knuthelgesen/Sustainer/docs/img/potentiometer_tab.jpg

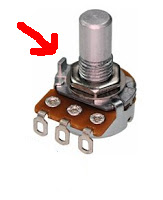
docs/img/potentiometer_tab.jpg
