knuthelgesen/Sustainer/docs/bilder/img_20200101_171444.jpg

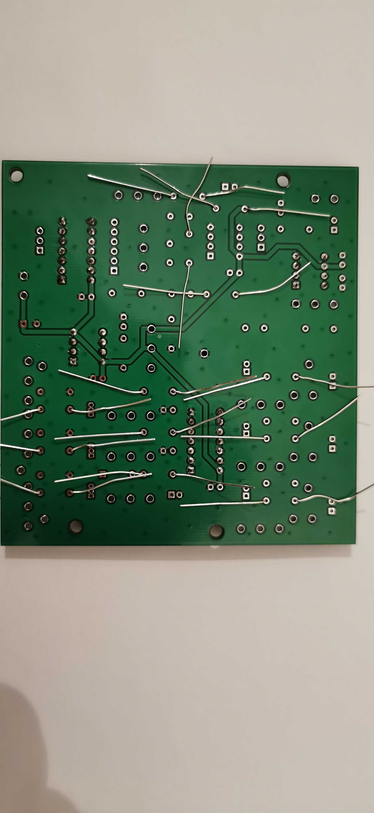
docs/bilder/img_20200101_171444.jpg
