knuthelgesen/Sustainer/docs/bilder/img_20200106_183125.jpg

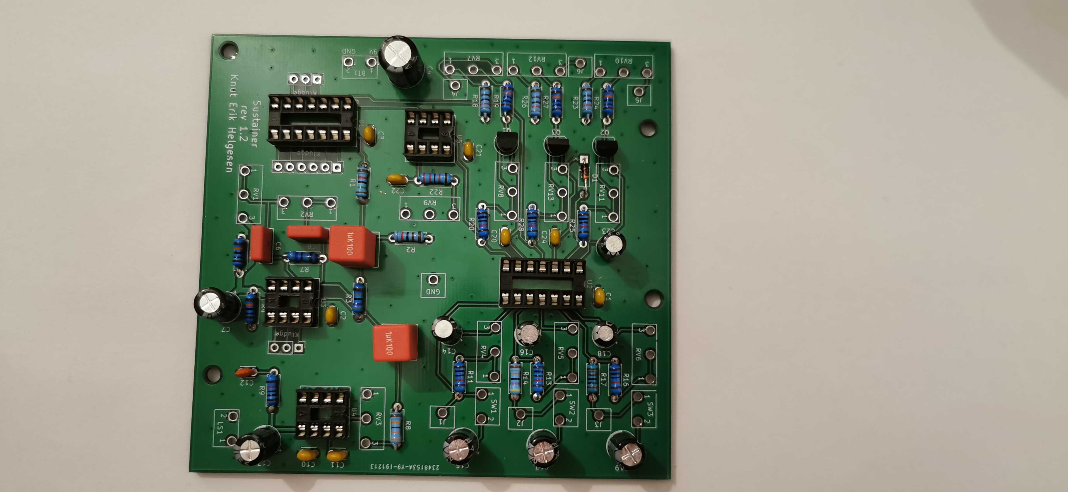
docs/bilder/img_20200106_183125.jpg
