knuthelgesen/Sustainer/docs/img/gated_oscillator.png

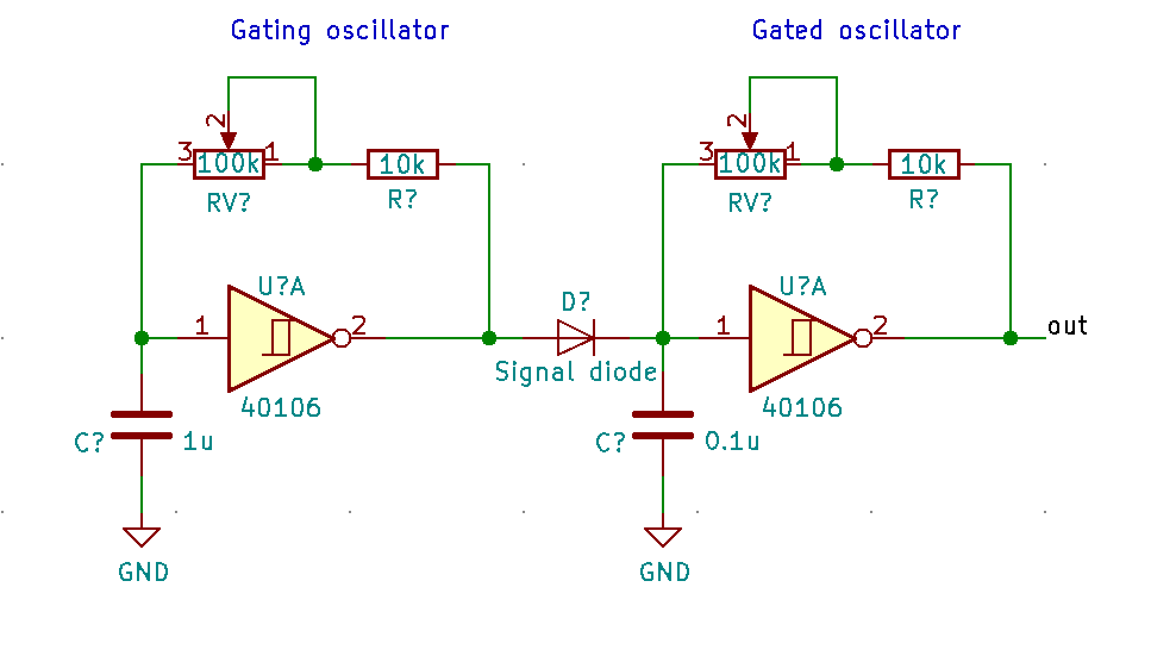
docs/img/gated_oscillator.png
