knuthelgesen/Sustainer/docs/img/potentiometer_pins.jpg

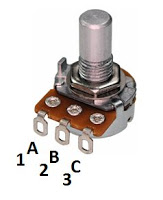
docs/img/potentiometer_pins.jpg
