knuthelgesen/Sustainer/docs/img/simple_oscillator.png

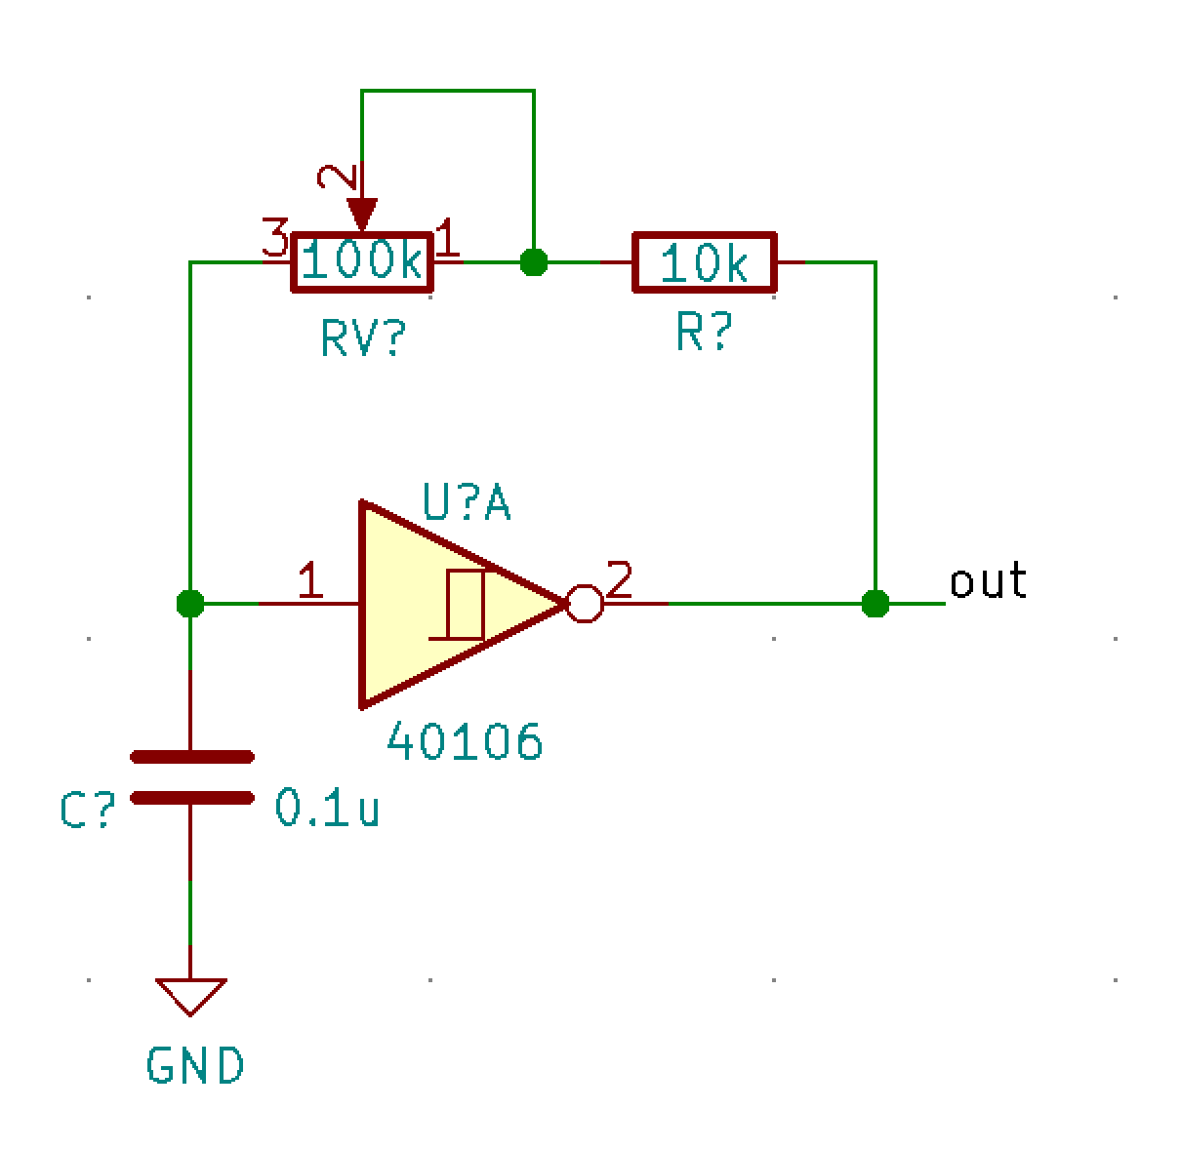
docs/img/simple_oscillator.png
