knuthelgesen/Sustainer/BOM.ods

Cateogry | Component | Count | Unit cost ($) | Total cost ($)
IC | CD40106 | 1 | $0.26 | $0.26
IC | LM358 | 1 | $0.16 | $0.16
IC | LM386 | 1 | $0.23 | $0.23
IC | CD4070 | 1 | $0.21 | $0.21
IC | NE555 | 1 | $0.13 | $0.13
Socket | 8 pin | 3 | 0.03
Socket | 14 pin | 2 | 0.05
Resistor | 1K
Potentiometer | 100K
Potentiometer | 1M
 |  |  |  | 0.99
