knuthelgesen/Sustainer/Sustainer.pdf

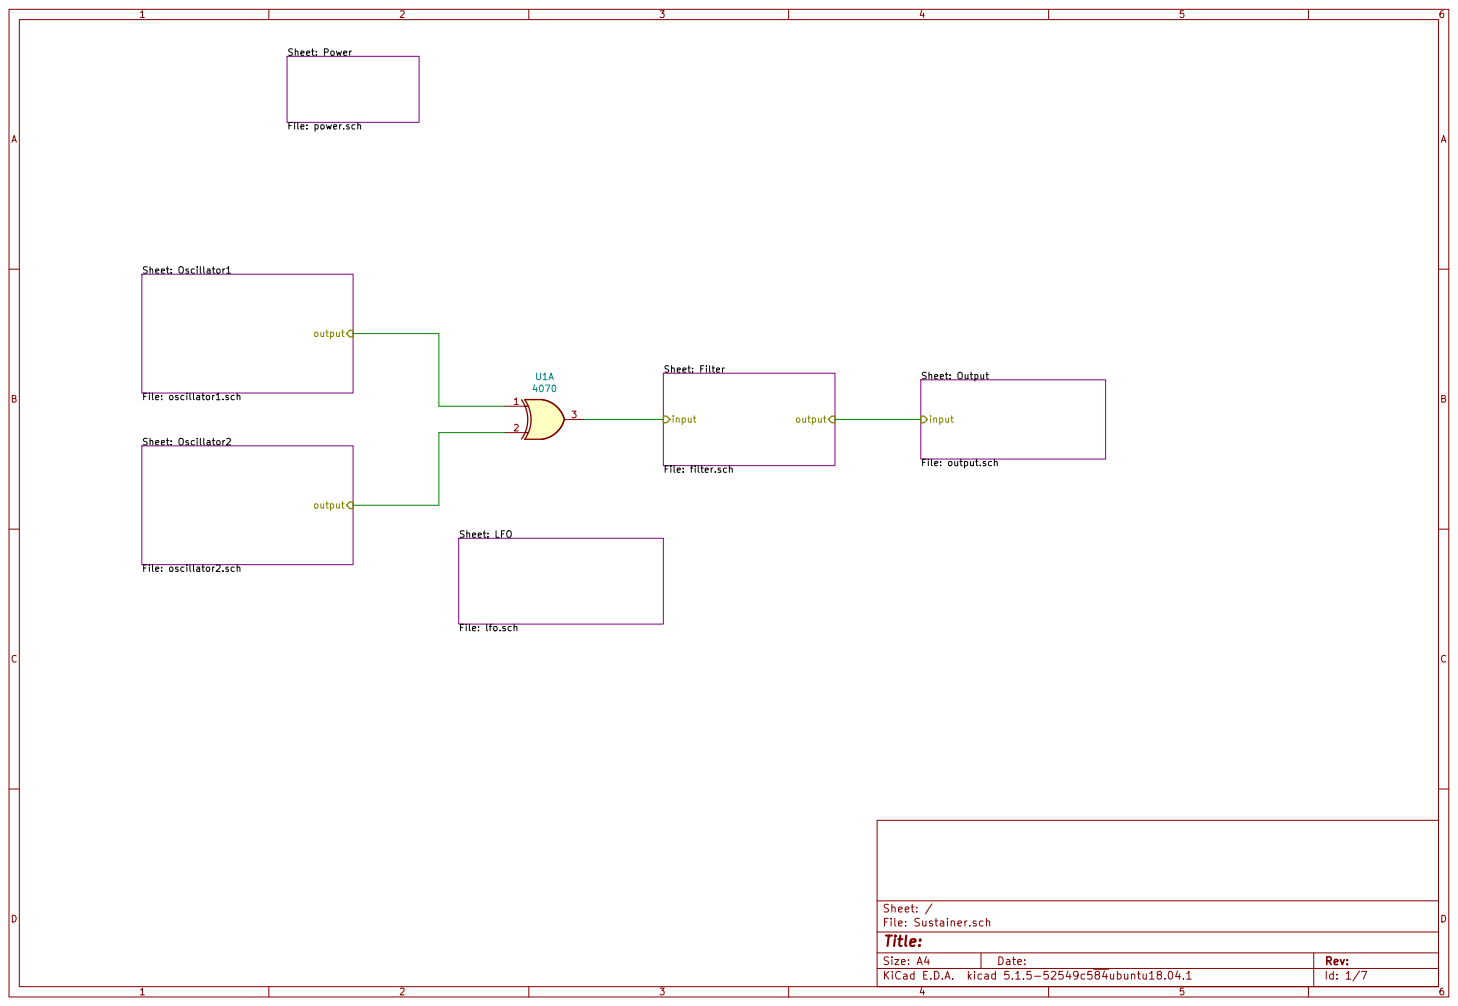
[picture p7: page 1]

File: lfo.sch Sheet: Oscillator1 File: oscillator1.sch

output Sheet: Oscillator2 File: oscillator2.sch

Id: 1/7 Title: File: Sustainer.sch Sheet: /

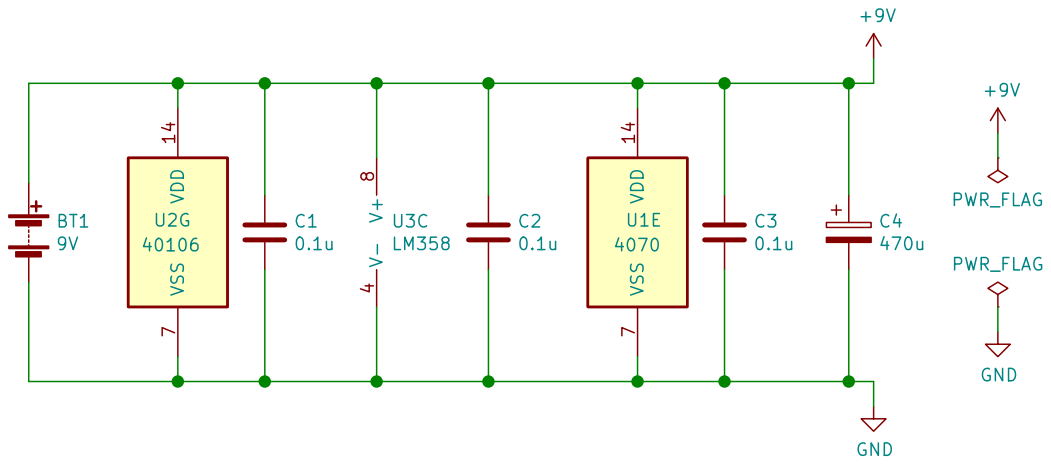
[picture p8: page 2]

File: power.sch Sheet: /Power/
Id: 2/7 Title:

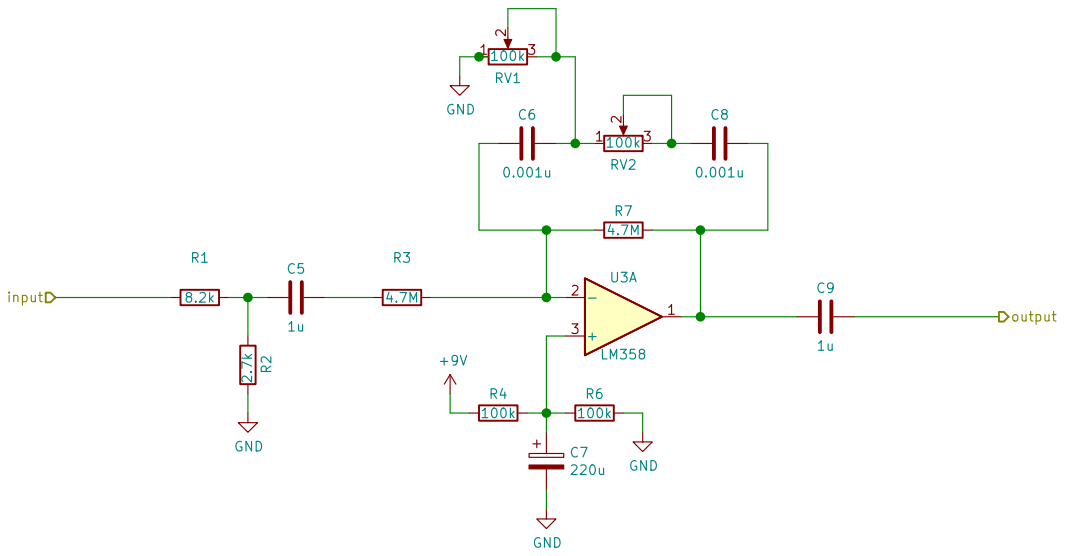
[picture p9: page 3]

Id: 3/7 Title: File: filter.sch Sheet: /Filter/ C5

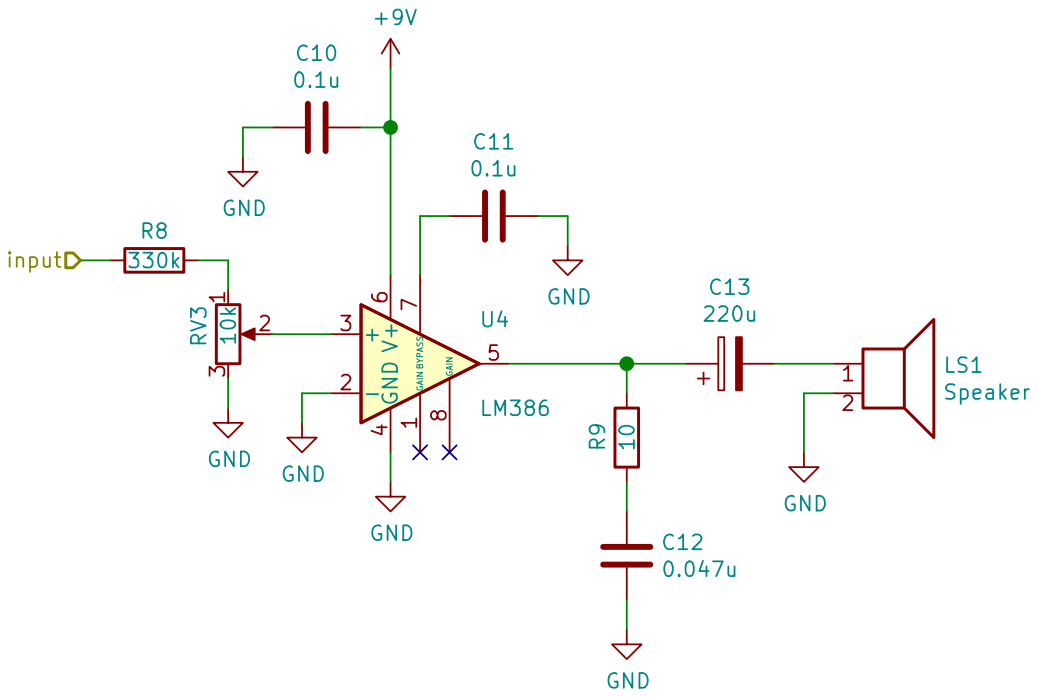
[picture p10: page 4]

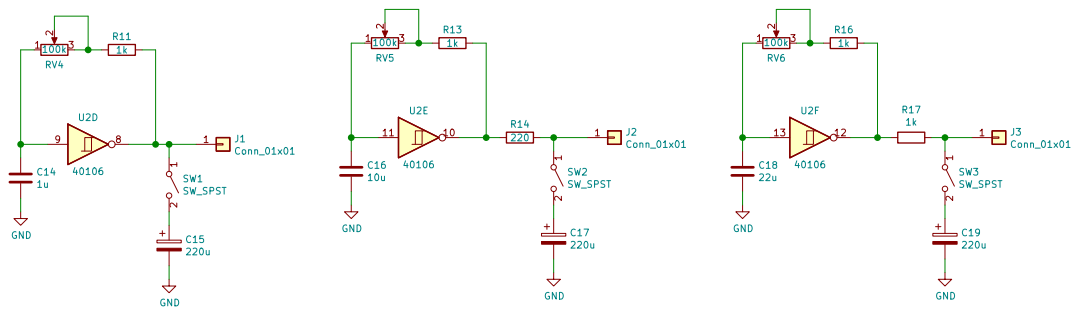
[picture p11: page 5]

40106 GND
Id: 5/7 Title: File: lfo.sch Sheet: /LFO/ C16

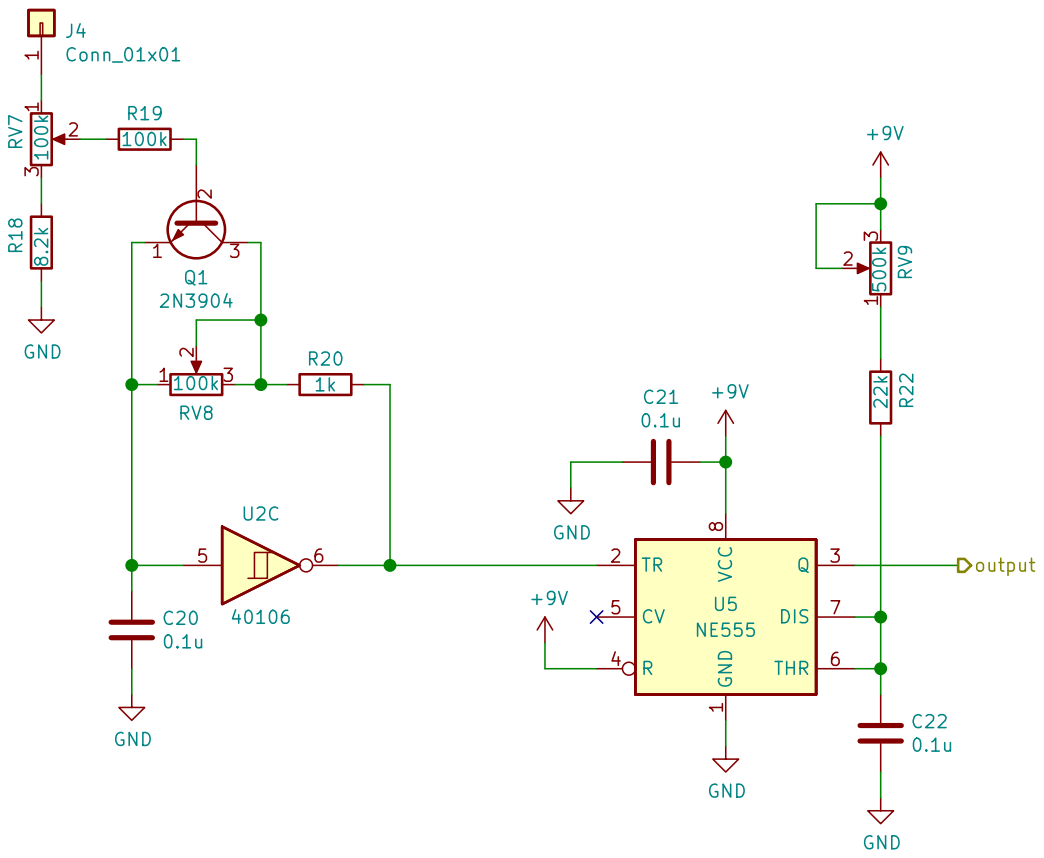
[picture p12: page 6]

Id: 6/7 Title: File: oscillator1.sch Sheet: /Oscillator1/

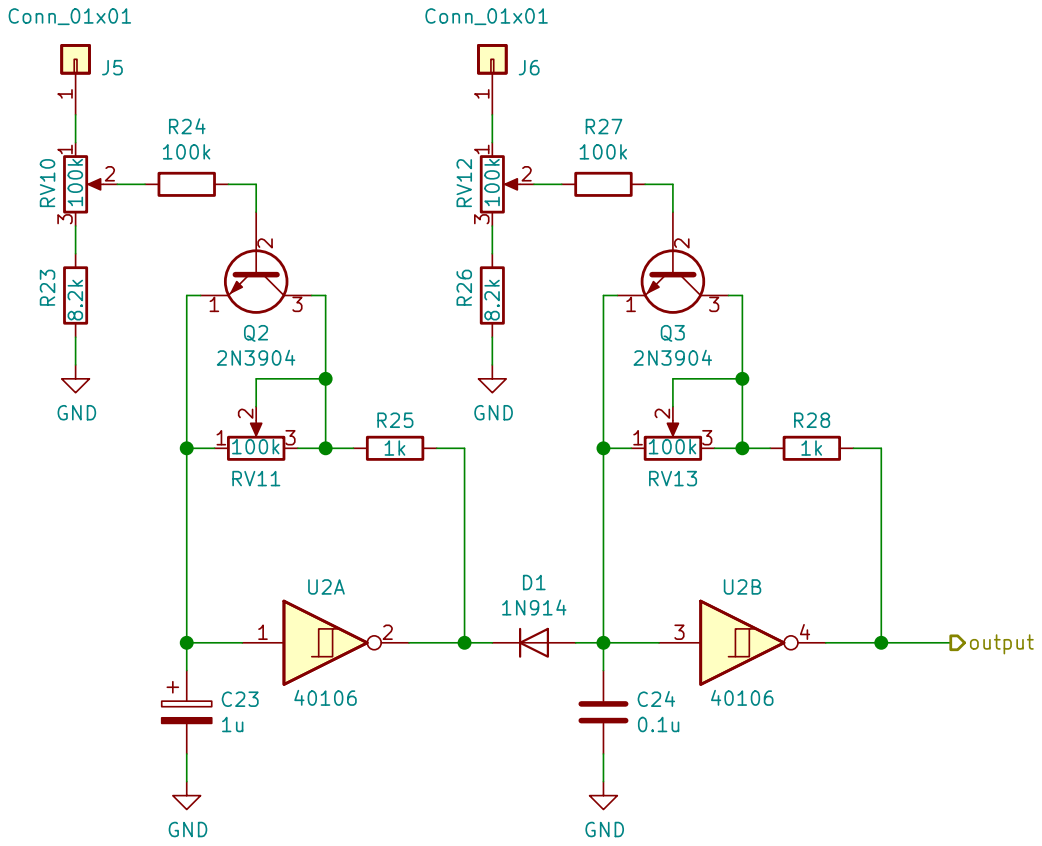
[picture p13: page 7]

Id: 7/7 Title: File: oscillator2.sch Sheet: /Oscillator2/
