knuthelgesen/Sustainer/Sustainer.kicad_pcb

## KiCad design Sustainer.kicad_pcb (2019-12-21)

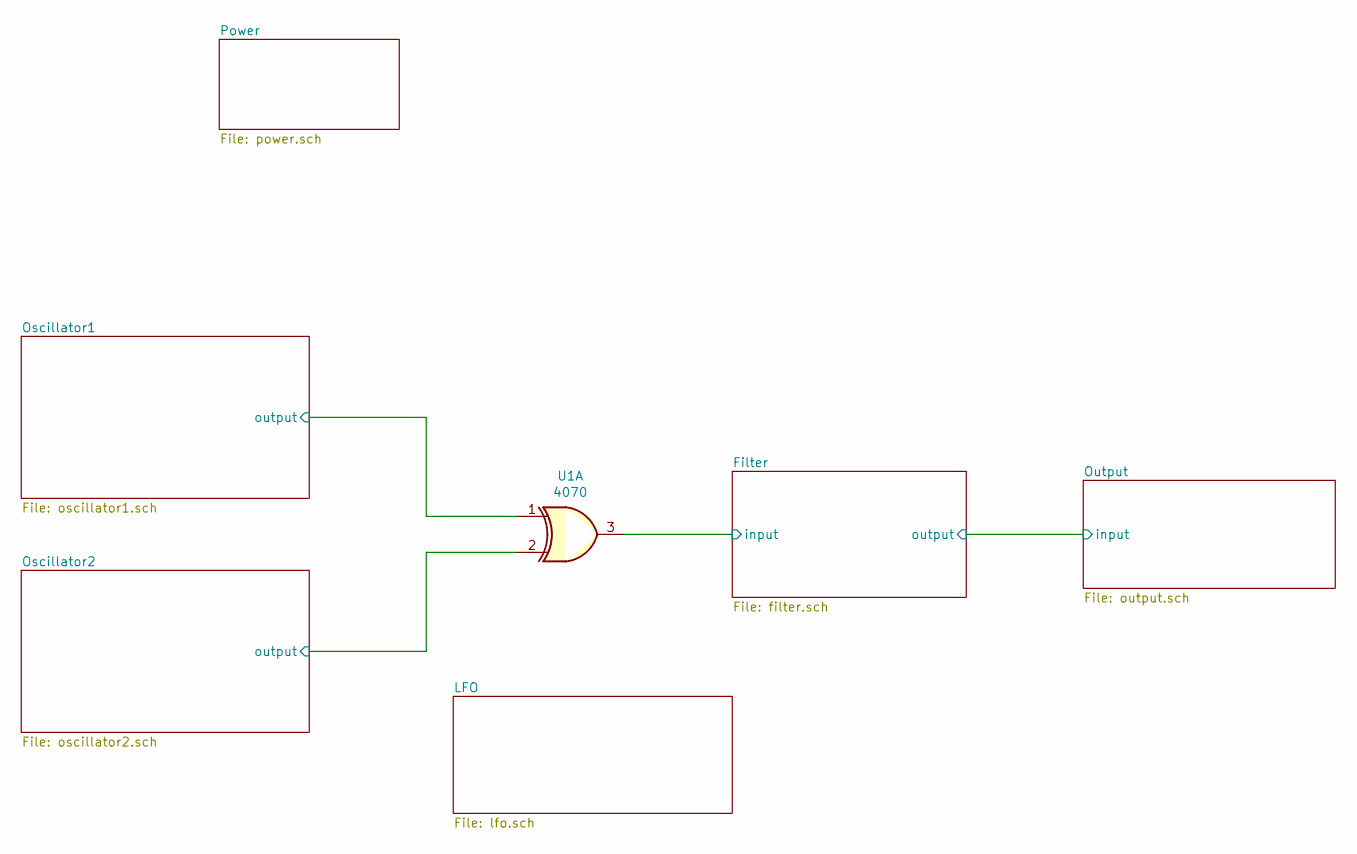
[picture p14: schematic Sustainer.sch]

Parts:
U1: 4070; DIP-14_W7.62mm_Socket

Connections:
/Filter/input: U1.3; also elsewhere on the board
/Oscillator1/output: U1.1; also elsewhere on the board
/Oscillator2/output: U1.2; also elsewhere on the board

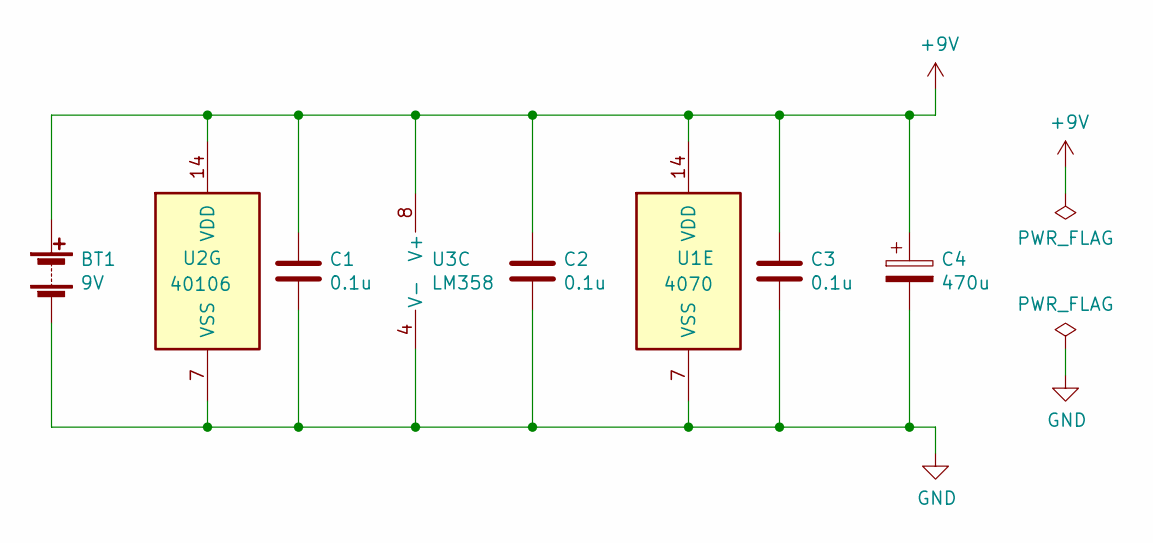
[picture p15: schematic power.sch]

Parts:
BT1: 9V; Connector_2x1_1.5mm
C1, C2, C3: 0.1u; C_Disc_D3.0mm_W2.0mm_P2.50mm
C4: 470u; CP_Radial_D8.0mm_P3.50mm
U1: 4070; DIP-14_W7.62mm_Socket
U2: 40106; DIP-14_W7.62mm_Socket
U3: LM358; DIP-8_W7.62mm_Socket

Connections:
+9V: BT1.1 (+), C1.1, C2.1, C3.1, C4.1, U1.14 (VDD), U2.14 (VDD), U3.8 (V+); also elsewhere on the board
GND: BT1.2 (-), C1.2, C2.2, C3.2, C4.2, U1.7 (VSS), U2.7 (VSS), U3.4 (V-); also elsewhere on the board

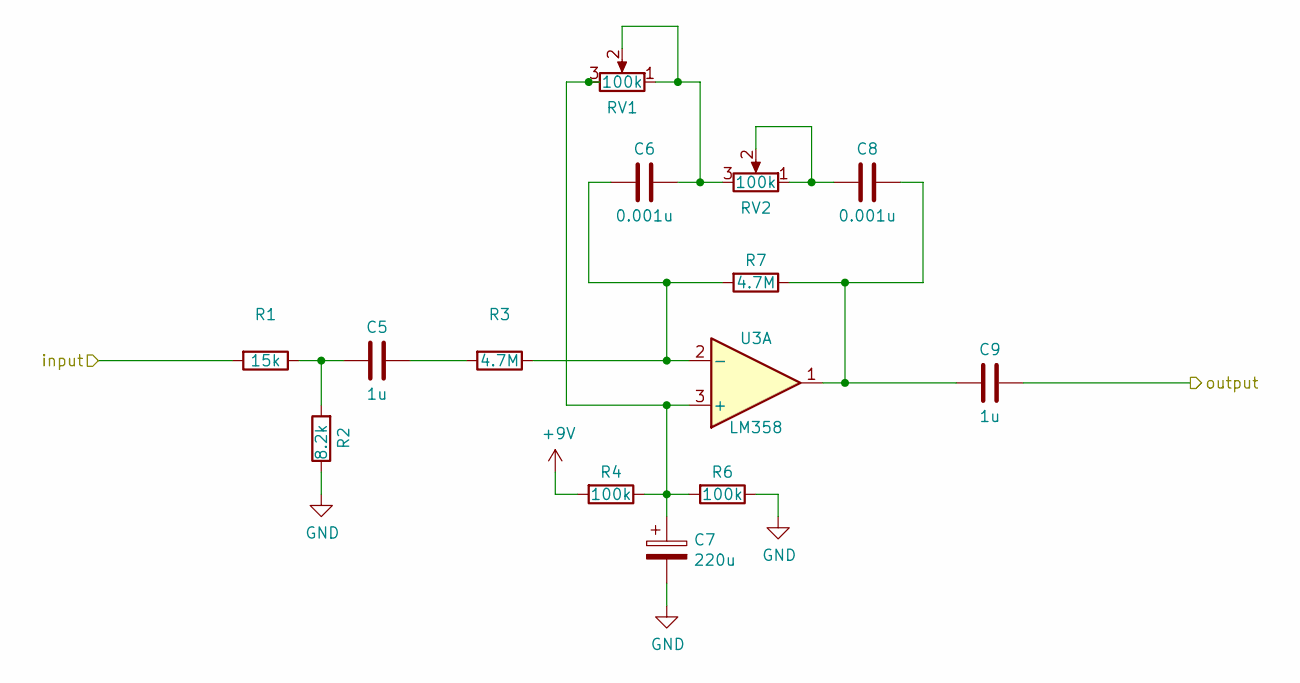
[picture p16: schematic filter.sch]

Parts:
C5, C9: 1u; C_Rect_L7.2mm_W7.2mm_P5.00mm_FKS2_FKP2_MKS2_MKP2
C6, C8: 0.001u; C_Rect_L7.2mm_W2.5mm_P5.00mm_FKS2_FKP2_MKS2_MKP2
C7: 220u; CP_Radial_D6.3mm_P2.50mm
R1: 15k; R_Axial_DIN0207_L6.3mm_D2.5mm_P7.62mm_Horizontal
R2: 8.2k; R_Axial_DIN0207_L6.3mm_D2.5mm_P7.62mm_Horizontal
R3, R7: 4.7M; R_Axial_DIN0207_L6.3mm_D2.5mm_P7.62mm_Horizontal
R4, R6: 100k; R_Axial_DIN0207_L6.3mm_D2.5mm_P7.62mm_Horizontal
RV1, RV2: 100k; Connector_3x1_1.5mm
U3: LM358; DIP-8_W7.62mm_Socket

Connections:
+9V: R4.2; also elsewhere on the board
/Filter/input: R1.2; also elsewhere on the board
/Output/input: C9.1; also elsewhere on the board
GND: C7.2, R2.1, R6.1; also elsewhere on the board
unnamed: C5.1, R3.2
unnamed: C5.2, R1.1, R2.2
unnamed: C6.1, RV1.1, RV1.2, RV2.3
unnamed: C6.2, R3.1, R7.2, U3.2 (-)
unnamed: C7.1, R4.1, R6.2, RV1.3, U3.3 (+)
unnamed: C8.1, C9.2, R7.1, U3.1
unnamed: C8.2, RV2.1, RV2.2

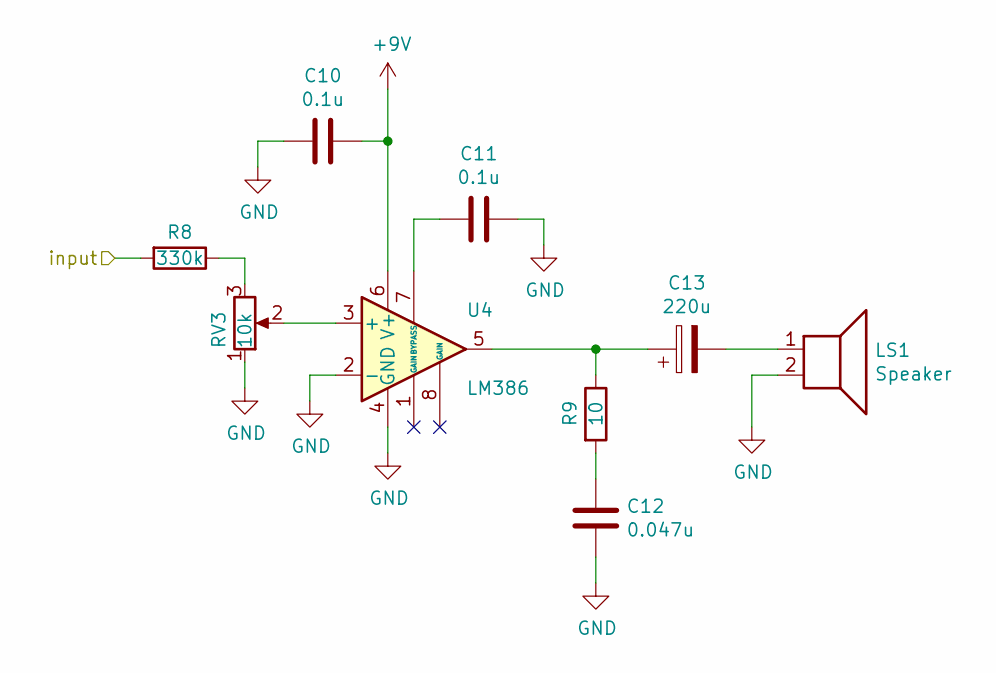
[picture p17: schematic output.sch]

Parts:
C10, C11: 0.1u; C_Disc_D3.0mm_W2.0mm_P2.50mm
C12: 0.047u; C_Disc_D3.0mm_W2.0mm_P2.50mm
C13: 220u; CP_Radial_D6.3mm_P2.50mm
LS1: Speaker; Connector_2x1_1.5mm
R8: 330k; R_Axial_DIN0207_L6.3mm_D2.5mm_P7.62mm_Horizontal
R9: 10; R_Axial_DIN0207_L6.3mm_D2.5mm_P7.62mm_Horizontal
RV3: 10k; Connector_3x1_1.5mm
U4: LM386; DIP-8_W7.62mm_Socket

Connections:
+9V: C10.1, U4.6 (V+); also elsewhere on the board
/Output/input: R8.2; also elsewhere on the board
GND: C10.2, C11.1, C12.2, LS1.2, RV3.1, U4.2 (-), U4.4 (GND); also elsewhere on the board
unnamed: C11.2, U4.7 (BYPASS)
unnamed: C12.1, R9.2
unnamed: C13.1, R9.1, U4.5
unnamed: C13.2, LS1.1
unnamed: R8.1, RV3.3
unnamed: RV3.2, U4.3 (+)

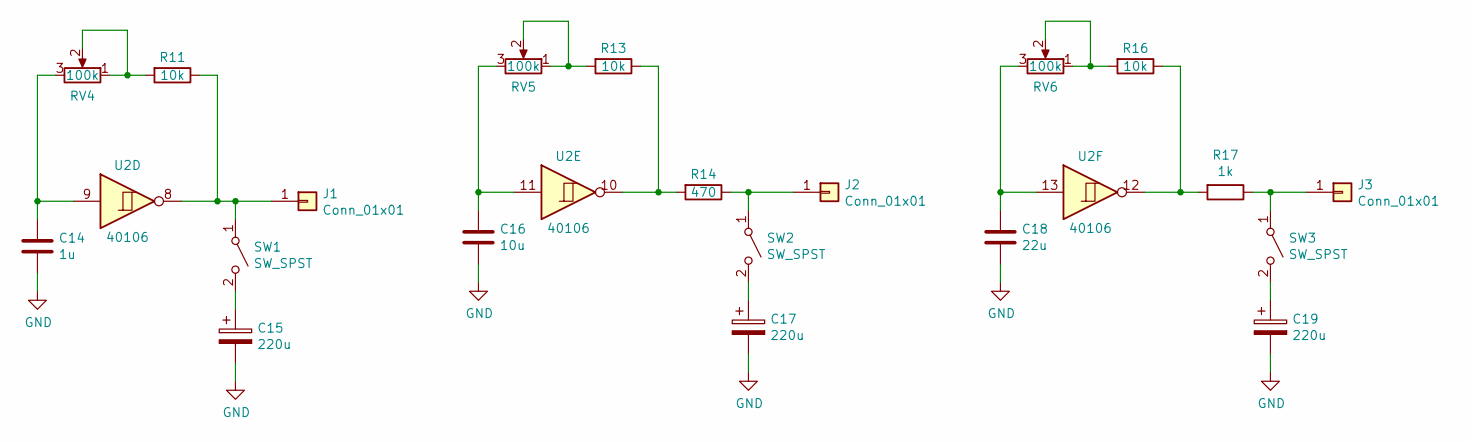
[picture p18: schematic lfo.sch]

Parts:
C14: 1u; CP_Radial_D5.0mm_P2.00mm
C15, C17, C19: 220u; CP_Radial_D6.3mm_P2.50mm
C16: 10u; CP_Radial_D5.0mm_P2.00mm
C18: 22u; CP_Radial_D5.0mm_P2.00mm
J1, J2, J3: Conn_01x01; Connector_1x1_1.5mm
R11, R13, R16: 10k; R_Axial_DIN0207_L6.3mm_D2.5mm_P7.62mm_Horizontal
R14: 470; R_Axial_DIN0207_L6.3mm_D2.5mm_P7.62mm_Horizontal
R17: 1k; R_Axial_DIN0207_L6.3mm_D2.5mm_P7.62mm_Horizontal
RV4, RV5, RV6: 100k; Connector_3x1_1.5mm
SW1, SW2, SW3: SW_SPST; Connector_2x1_1.5mm
U2: 40106; DIP-14_W7.62mm_Socket

Connections:
GND: C14.2, C15.2, C16.2, C17.2, C18.2, C19.2; also elsewhere on the board
unnamed: C14.1, RV4.3, U2.9
unnamed: C15.1, SW1.2 (B)
unnamed: C16.1, RV5.3, U2.11
unnamed: C17.1, SW2.2 (B)
unnamed: C18.1, RV6.3, U2.13
unnamed: C19.1, SW3.2 (B)
unnamed: J1.1, R11.1, SW1.1 (A), U2.8
unnamed: J2.1, R14.1, SW2.1 (A)
unnamed: J3.1, R17.1, SW3.1 (A)
unnamed: R11.2, RV4.1, RV4.2
unnamed: R13.1, R14.2, U2.10
unnamed: R13.2, RV5.1, RV5.2
unnamed: R16.1, R17.2, U2.12
unnamed: R16.2, RV6.1, RV6.2

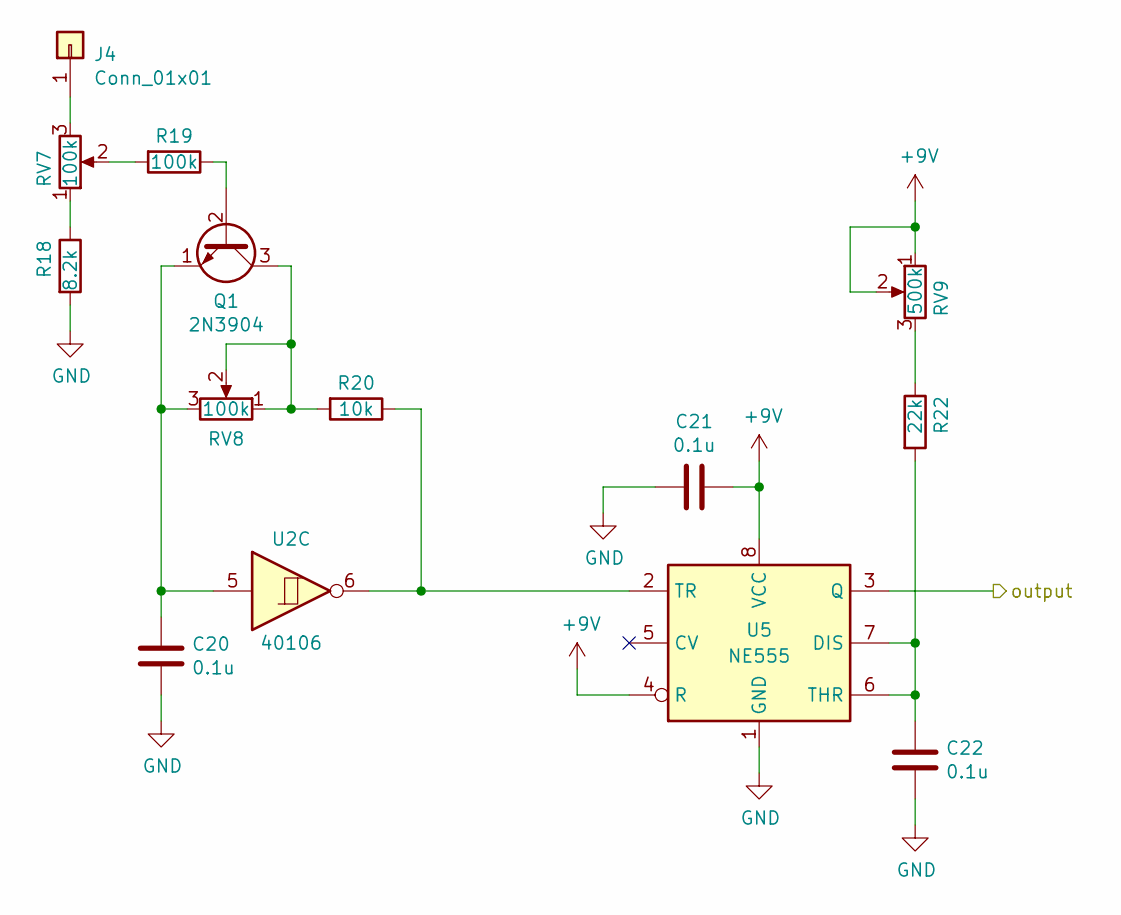
[picture p19: schematic oscillator1.sch]

Parts:
C20, C21, C22: 0.1u; C_Disc_D3.0mm_W2.0mm_P2.50mm
J4: Conn_01x01; Connector_1x1_1.5mm
Q1: 2N3904; TO-92_Inline
R18: 8.2k; R_Axial_DIN0207_L6.3mm_D2.5mm_P7.62mm_Horizontal
R19: 100k; R_Axial_DIN0207_L6.3mm_D2.5mm_P7.62mm_Horizontal
R20: 10k; R_Axial_DIN0207_L6.3mm_D2.5mm_P7.62mm_Horizontal
R22: 22k; R_Axial_DIN0207_L6.3mm_D2.5mm_P7.62mm_Horizontal
RV7, RV8: 100k; Connector_3x1_1.5mm
RV9: 500k; Connector_3x1_1.5mm
U2: 40106; DIP-14_W7.62mm_Socket
U5: NE555; DIP-8_W7.62mm_Socket

Connections:
+9V: C21.1, RV9.1, RV9.2, U5.4 (R), U5.8 (VCC); also elsewhere on the board
/Oscillator1/output: U5.3 (Q); also elsewhere on the board
GND: C20.2, C21.2, C22.2, R18.2, U5.1 (GND); also elsewhere on the board
unnamed: C20.1, Q1.1 (E), RV8.3, U2.5
unnamed: C22.1, R22.2, U5.6 (THR), U5.7 (DIS)
unnamed: J4.1, RV7.3
unnamed: Q1.2 (B), R19.1
unnamed: Q1.3 (C), R20.2, RV8.1, RV8.2
unnamed: R18.1, RV7.1
unnamed: R19.2, RV7.2
unnamed: R20.1, U2.6, U5.2 (TR)
unnamed: R22.1, RV9.3

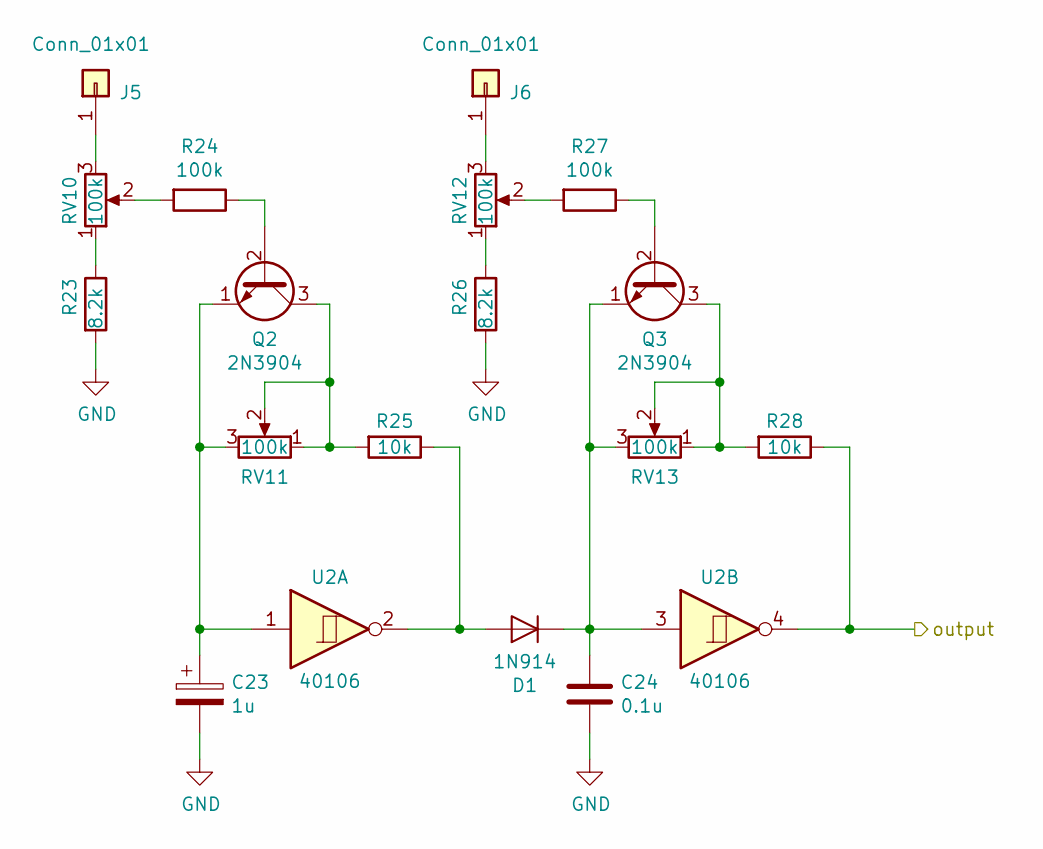
[picture p20: schematic oscillator2.sch]

Parts:
C23: 1u; CP_Radial_D5.0mm_P2.00mm
C24: 0.1u; C_Disc_D3.0mm_W2.0mm_P2.50mm
D1: 1N914; D_DO-35_SOD27_P7.62mm_Horizontal
J5, J6: Conn_01x01; Connector_1x1_1.5mm
Q2, Q3: 2N3904; TO-92_Inline
R23, R26: 8.2k; R_Axial_DIN0207_L6.3mm_D2.5mm_P7.62mm_Horizontal
R24, R27: 100k; R_Axial_DIN0207_L6.3mm_D2.5mm_P7.62mm_Horizontal
R25, R28: 10k; R_Axial_DIN0207_L6.3mm_D2.5mm_P7.62mm_Horizontal
RV10, RV11, RV12, RV13: 100k; Connector_3x1_1.5mm
U2: 40106; DIP-14_W7.62mm_Socket

Connections:
/Oscillator2/output: R28.1, U2.4; also elsewhere on the board
GND: C23.2, C24.2, R23.2, R26.2; also elsewhere on the board
unnamed: C23.1, Q2.1 (E), RV11.3, U2.1
unnamed: C24.1, D1.1 (K), Q3.1 (E), RV13.3, U2.3
unnamed: D1.2 (A), R25.1, U2.2
unnamed: J5.1, RV10.3
unnamed: J6.1, RV12.3
unnamed: Q2.2 (B), R24.1
unnamed: Q2.3 (C), R25.2, RV11.1, RV11.2
unnamed: Q3.2 (B), R27.1
unnamed: Q3.3 (C), R28.2, RV13.1, RV13.2
unnamed: R23.1, RV10.1
unnamed: R24.2, RV10.2
unnamed: R26.1, RV12.1
unnamed: R27.2, RV12.2

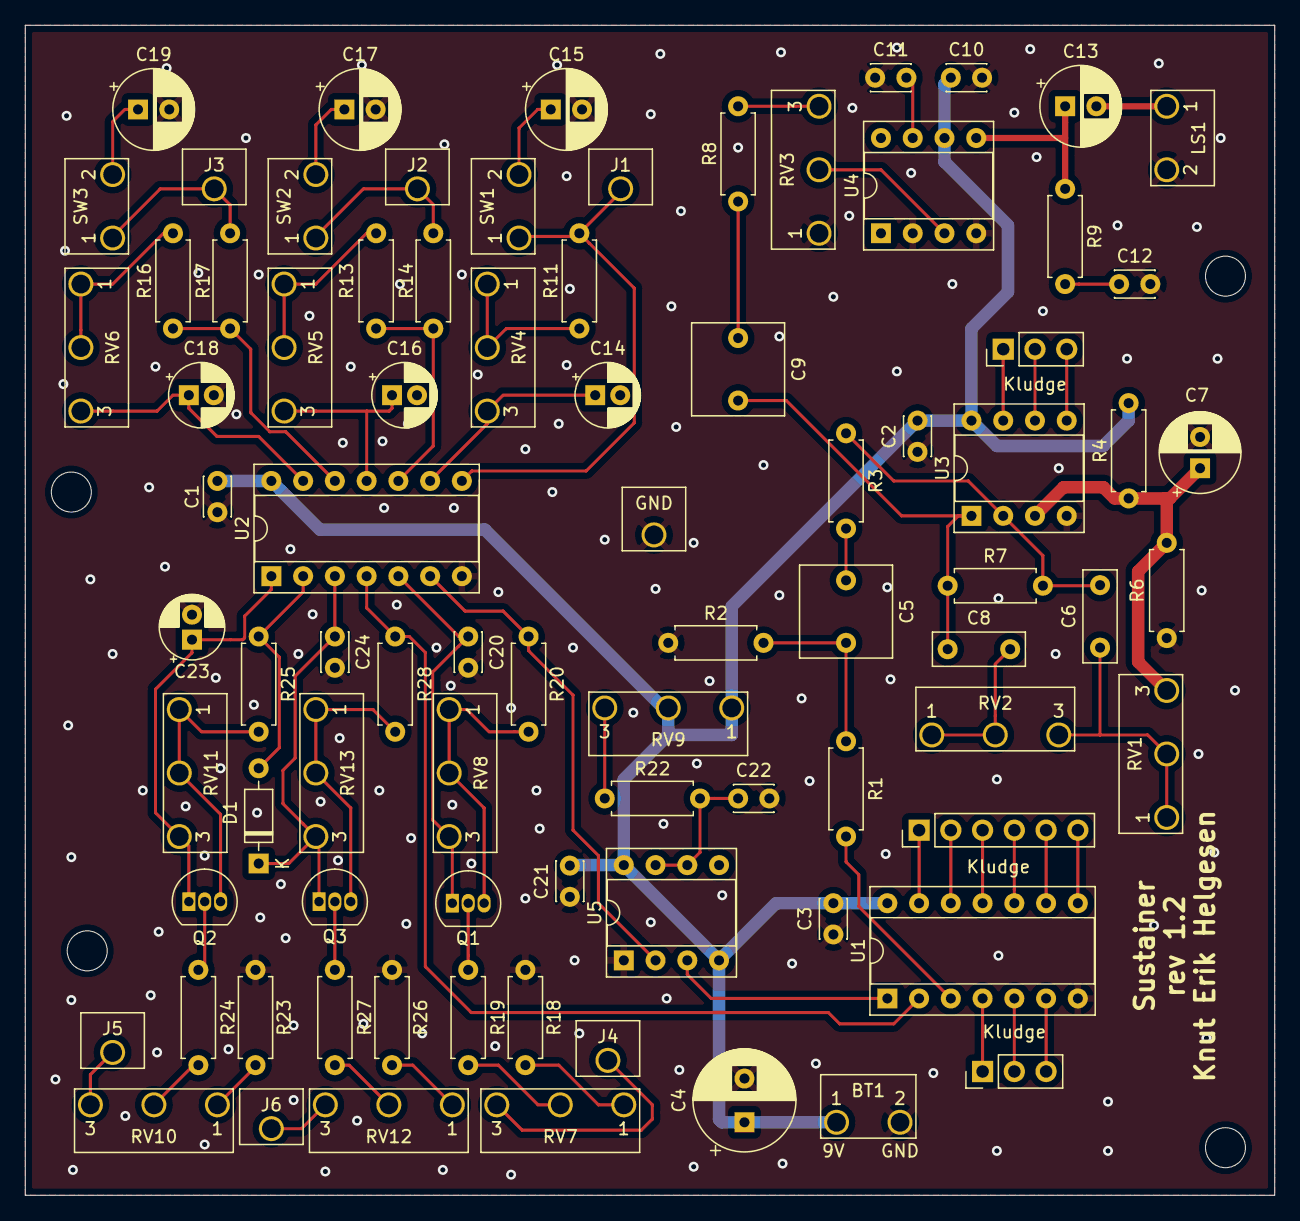
[picture p21: board Sustainer.kicad_pcb from above]

Board: 2 copper layers, 99.9 x 93.6 mm, 81 parts (0 on the bottom side), 55 nets.

Other parts of the board:
GND: Connector_1x1_1.5mm

Their connections:
GND: GND.1; also elsewhere on the board
