knuthelgesen/Sustainer/(commit log)

2020-01-06 Updated docs
    [Sustainer.sch, examples.sch, filter.sch, lfo.sch, oscillator_a.sch, oscillator_b.sch, output.sch, power.sch]
2020-02-17 Small changes to the Schematics for readability More docs Add abstract for Booster
    [Sustainer.sch, examples.sch, filter.sch, lfo.sch, oscillator_a.sch, oscillator_b.sch, output.sch, power.sch]
2020-02-28 Some suggestions for breadboard layout
    [filter.sch, output.sch]
2020-03-05 More docs and suggested breadboard layouts
    [output.sch]
